Mrunmoy/pico-3d-mouse/mechanical/README.txt

Current mechanical documentation: README.md
Current master: output/two-piece/SpaceMouse_TwoPiece.f3d
Earlier output folders are historical revisions, not current print parts.
