Mrunmoy/pico-3d-mouse/mechanical/om300b.pdf

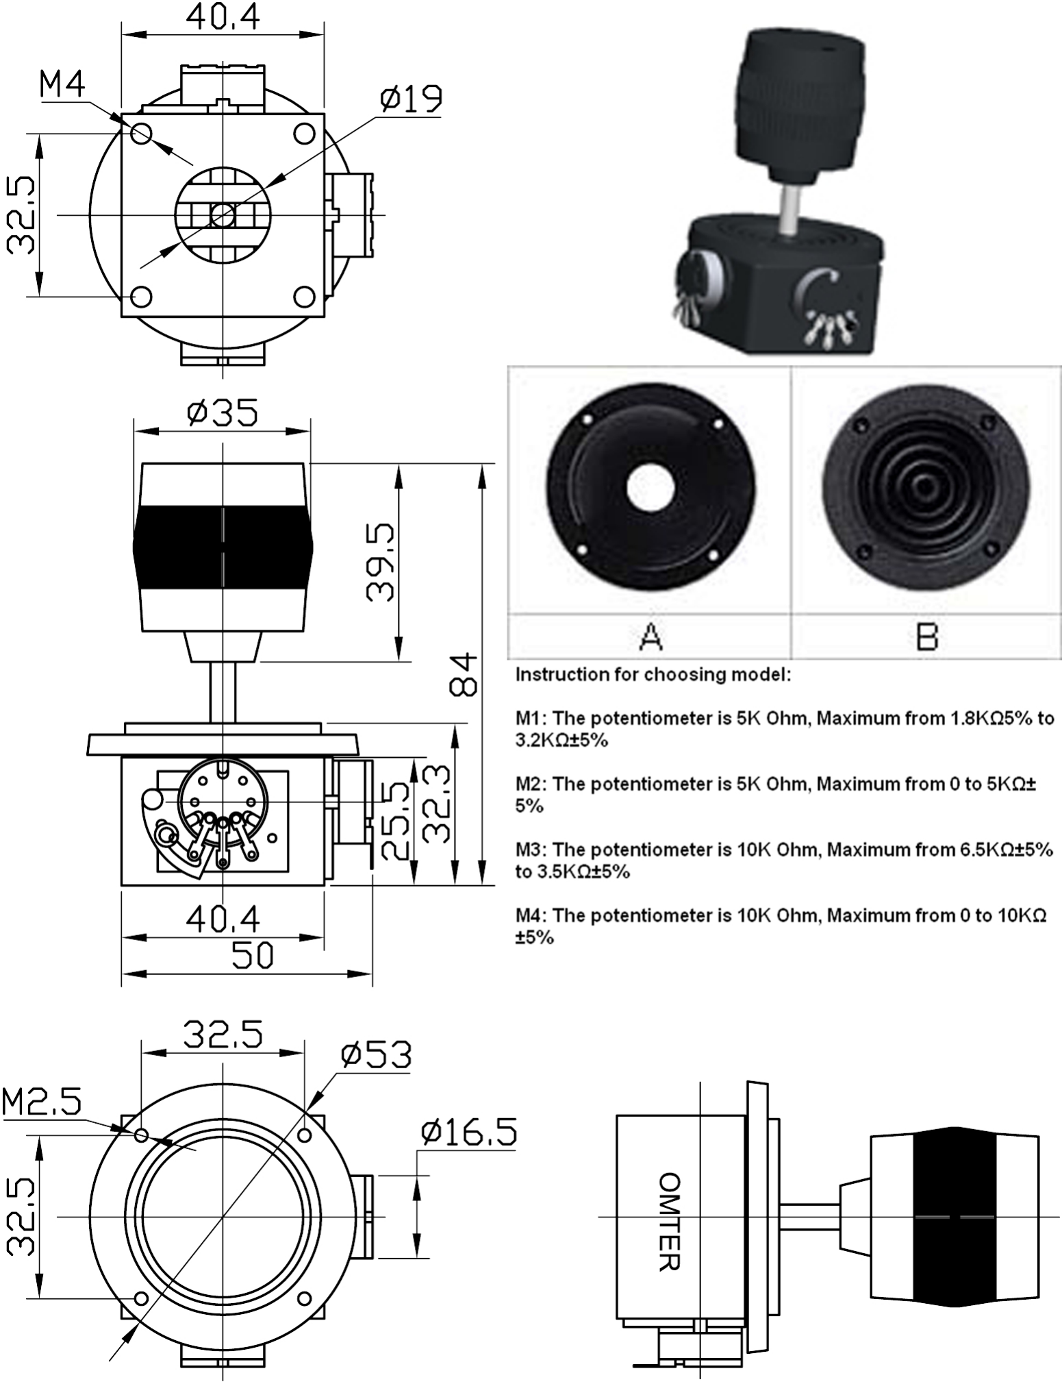
[picture p14: page 1]
