Mrunmoy/pico-3d-mouse/mechanical/docs/images/joint-section.png

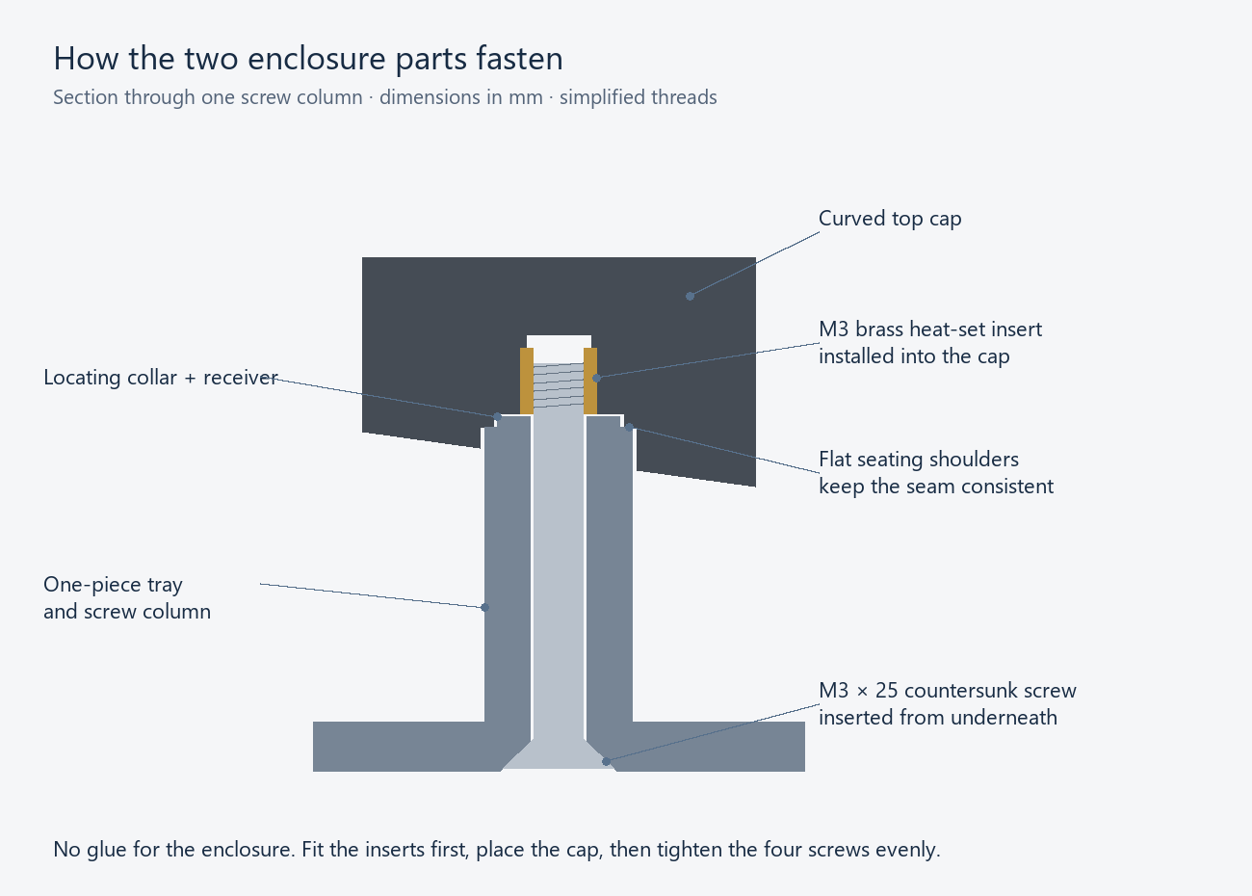
mechanical/docs/images/joint-section.png
