Mrunmoy/pico-3d-mouse/mechanical/output/two-piece/Bambu_top_and_retainer_ready.png

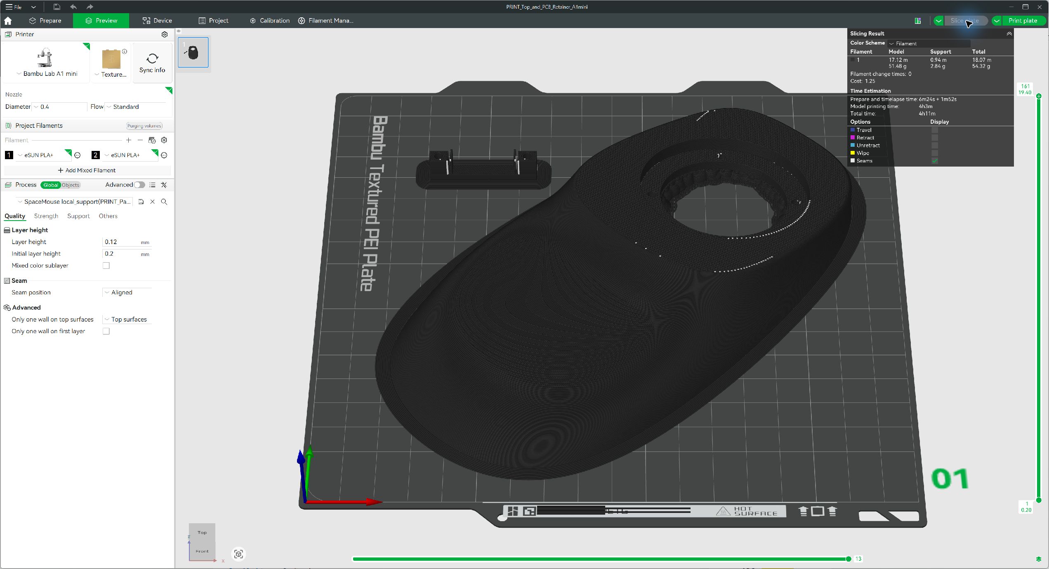
mechanical/output/two-piece/Bambu_top_and_retainer_ready.png
