Mrunmoy/pico-3d-mouse/mechanical/output/two-piece/Left_hand_top.png

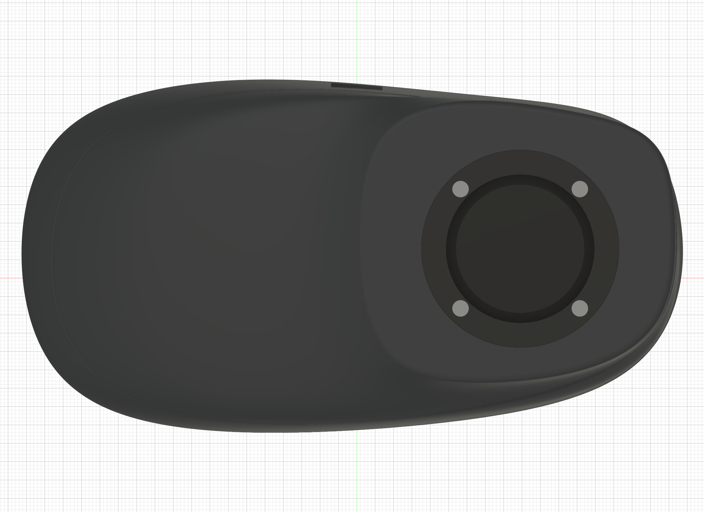
mechanical/output/two-piece/Left_hand_top.png
