Mrunmoy/pico-3d-mouse/mechanical/output/two-piece/TPU_Strip_2_print.stl

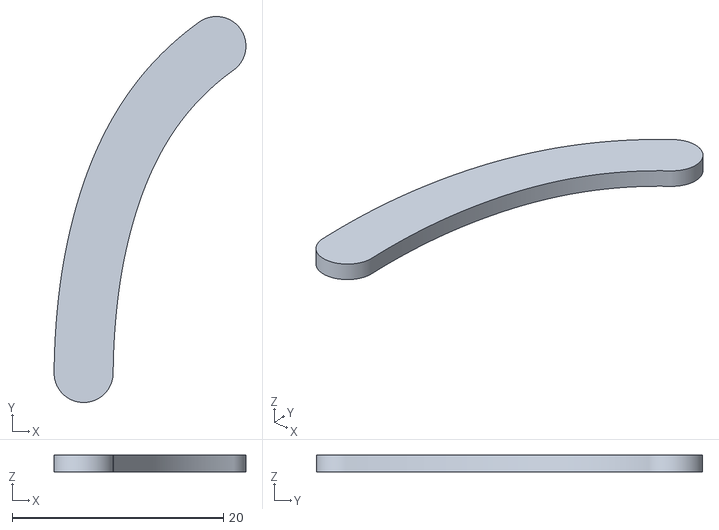
[picture p18: CAD file, 2026-10-29]
mechanical/output/two-piece/TPU_Strip_2_print.stl
18.2 x 36.6 x 1.60
