Mrunmoy/pico-3d-mouse/mechanical/output/two-piece/TPU_Strip_1_print.stl

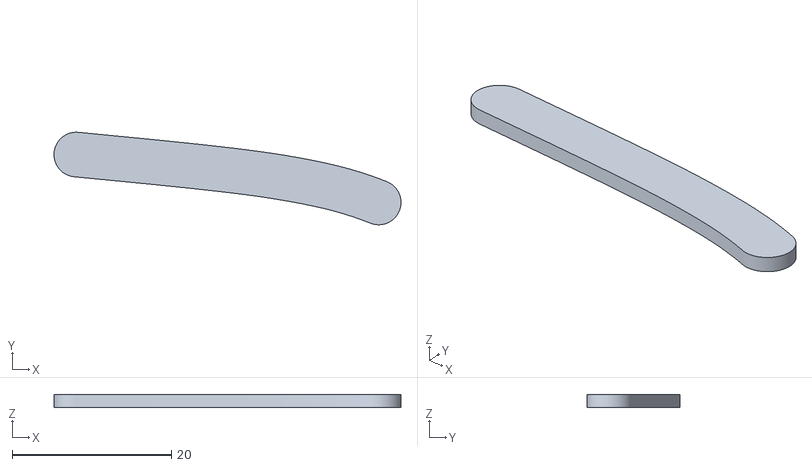
[picture p19: CAD file, 2026-10-29]
mechanical/output/two-piece/TPU_Strip_1_print.stl
43.5 x 11.6 x 1.60
