Mrunmoy/pico-3d-mouse/mechanical/output/two-piece/TPU_Strip_3_print.stl

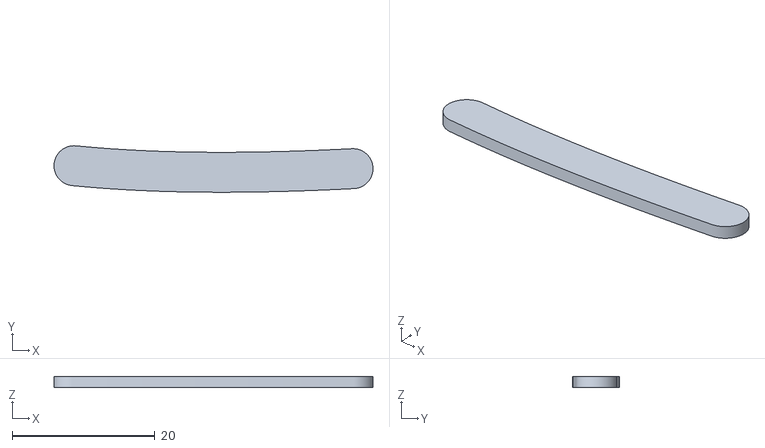
[picture p20: CAD file, 2026-10-29]
mechanical/output/two-piece/TPU_Strip_3_print.stl
44.7 x 6.52 x 1.60
