Mrunmoy/pico-3d-mouse/mechanical/output/two-piece/TPU_Strip_4_print.stl

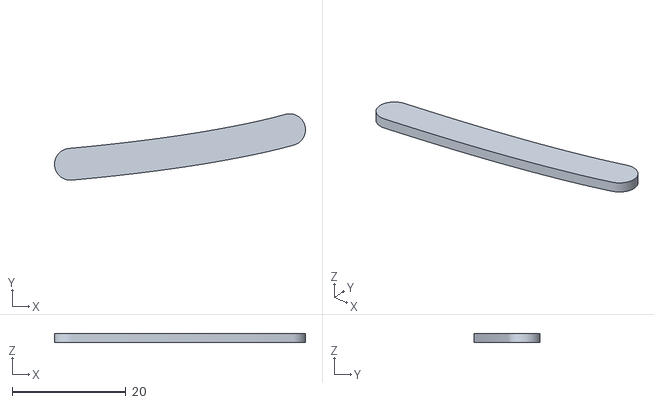
[picture p21: CAD file, 2026-10-29]
mechanical/output/two-piece/TPU_Strip_4_print.stl
44.1 x 11.7 x 1.60
