Mrunmoy/pico-3d-mouse/mechanical/output/two-piece/Base_Tray_print.stl

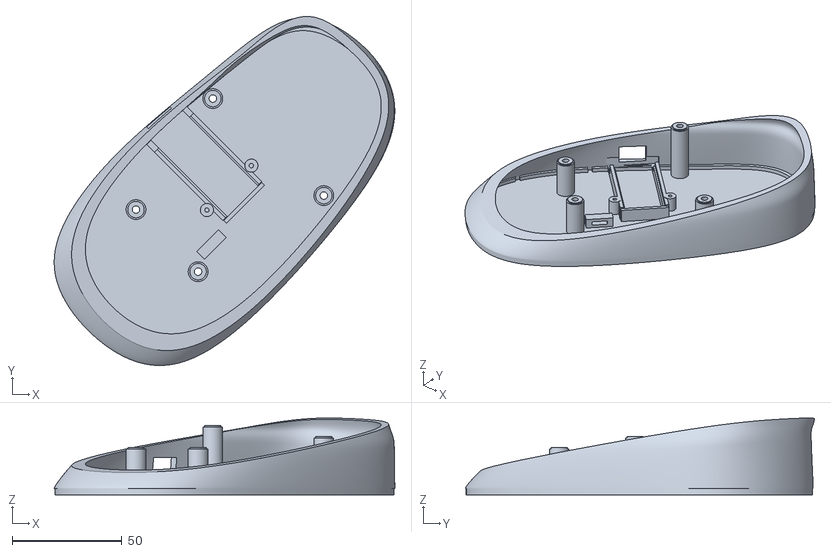
[picture p22: CAD file, 2026-10-29]
mechanical/output/two-piece/Base_Tray_print.stl
155.1 x 159.0 x 35.1
