Mrunmoy/pico-3d-mouse/mechanical/output/two-piece/PRINT_Top_and_PCB_Retainer_A1mini.3mf

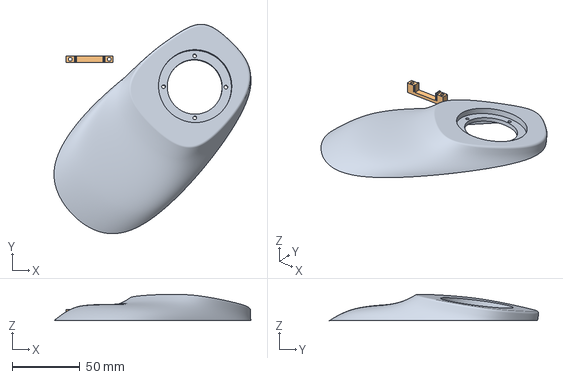
[picture p23: CAD file, 2026-10-29]
mechanical/output/two-piece/PRINT_Top_and_PCB_Retainer_A1mini.3mf
144.9 x 154.0 x 19.4 mm
Palm_Cap
PCB_Retainer_print.stl
