Mrunmoy/pico-3d-mouse/mechanical/output/two-piece/PCB_Retainer_print.stl

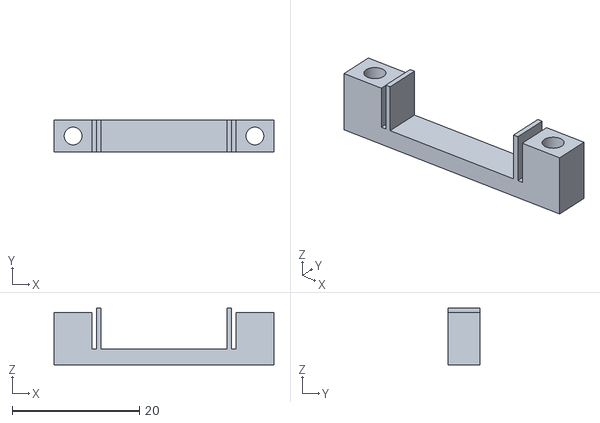
[picture p24: CAD file, 2026-10-29]
mechanical/output/two-piece/PCB_Retainer_print.stl
34.6 x 5.00 x 8.90
