Mrunmoy/pico-3d-mouse/mechanical/output/two-piece/Palm_Cap_print.stl

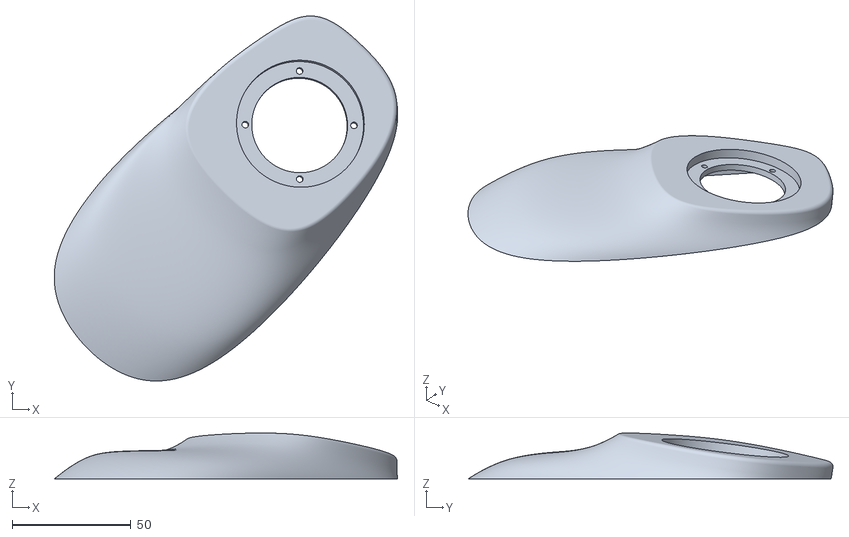
[picture p25: CAD file, 2026-10-29]
mechanical/output/two-piece/Palm_Cap_print.stl
144.9 x 154.0 x 19.4
