Mrunmoy/pico-3d-mouse/(list of files, cad)

Other CAD files:
mechanical/output/two-piece/PRINT_Base_Tray_A1mini.3mf
mechanical/output/two-piece/SpaceMouse_TwoPiece.f3d
