Mrunmoy/pico-3d-mouse/(commit log)

2026-10-24 Revise Concept C hand layout and add measured flush joystick mount
    [Bottom_Cover_print.stl, ConceptC_Complete.f3d, ConceptC_Complete_Assembly.step, ConceptC_Exploded.f3d, ConceptC_Palm25.f3d, PCB_Retainer_print.stl, Upper_Shell_print.3mf, Upper_Shell_print.stl]
2026-10-24 Record single R2 master in SpaceMouse and close extra Fusion tabs
    [ConceptC_Complete.f3d]
2026-10-24 Remove four obsolete cloud mouse prototypes and preserve R2 master
2026-10-24 Lower front palm support with gentle slope and shallow ergonomic cradle
    [SpaceMouse_Master.f3d, Upper_Shell_print.stl]
2026-10-24 Export SpaceMouse CAD reference views and ergonomic concept brief
2026-10-24 Lower finger shoulder and blend SpaceMouse shell into continuous ramp
    [SpaceMouse_Master.f3d, Upper_Shell_print.stl]
2026-10-25 Round SpaceMouse crown and shorten hand-entry edge by 12 mm
    [Bottom_Cover_print.stl, PCB_Retainer_print.stl, SpaceMouse_Master.f3d, Upper_Shell_print.stl]
2026-10-25 Restore asymmetric palm support and smooth SpaceMouse sidewalls
    [Bottom_Cover_print.stl, PCB_Retainer_print.stl, SpaceMouse_Master.f3d, Upper_Shell_print.stl]
2026-10-25 Replace round feet with curved perimeter TPU inserts
    [Bottom_Cover_print.stl, SpaceMouse_Master.f3d, TPU_Strip_1_print.stl, TPU_Strip_2_print.stl, TPU_Strip_3_print.stl, TPU_Strip_4_print.stl]
2026-10-25 Save A1 Mini top cover slicing setup with supports and brim
    [Top_Cover_A1mini_0p12.3mf]
2026-10-25 Save separate split-shell review concept and CAD previews
    [Bottom_Cover_NoSupports_Audit.3mf, Bottom_Cover_print.stl, Lower_Frame_NoSupports_Audit.3mf, Lower_Frame_print.stl, Palm_Cap_NoSupports_Audit.3mf, Palm_Cap_print.stl, SpaceMouse_Split_Concept.f3d]
2026-10-25 Build two-piece tray and registered cap with countersunk M3 fastening
    [Base_Tray_NoSupports_Audit.3mf, Base_Tray_print.stl, Palm_Cap_NoSupports_Audit.3mf, Palm_Cap_print.stl, SpaceMouse_TwoPiece.f3d]
2026-10-25 Distribute case fixings and validate final two-piece slicing
    [Base_Tray_NoSupports_Audit.3mf, Base_Tray_print.stl, PRINT_Base_Tray_A1mini.3mf, PRINT_Palm_Cap_A1mini.3mf, Palm_Cap_NoSupports_Audit.3mf, Palm_Cap_print.stl, SpaceMouse_TwoPiece.f3d]
2026-10-25 Keep latest SpaceMouse as the single Fusion master
    [SpaceMouse_TwoPiece.f3d]
2026-10-25 Correct left-hand assembly and regenerate validated print projects
    [Base_Tray_NoSupports_Audit.3mf, Base_Tray_print.stl, PRINT_Base_Tray_A1mini.3mf, PRINT_Palm_Cap_A1mini.3mf, Palm_Cap_NoSupports_Audit.3mf, Palm_Cap_print.stl, SpaceMouse_TwoPiece.f3d]
2026-10-27 Check long insert clearance and preserve safe cap geometry
    [SpaceMouse_TwoPiece.f3d]
2026-10-27 Adapt palm cap to Amazon M3 L4 D4.2 inserts and refresh print exports
    [PRINT_Palm_Cap_A1mini.3mf, Palm_Cap_NoSupports_Audit.3mf, Palm_Cap_print.stl, SpaceMouse_TwoPiece.f3d]
2026-10-27 Package cap and PCB retainer on one Bambu plate and assess tilt adhesion
    [PCB_Retainer_print.stl, PRINT_Top_and_PCB_Retainer_A1mini.3mf]
2026-10-29 Initial commit: RP2040 3-channel ADC potentiometer driver and bringup firmware
2026-10-29 Refactor to SOLID modular architecture with colocated TDD tests, scripts, and wiring diagram
2026-10-29 feat(firmware): add composite 6-DOF USB HID, QSPI flash calibration store, and buttonless BOOTSEL command
2026-10-29 feat(ui): add event-driven Qt6 MVC manufacturing tester, calibration, and buttonless firmware updater
2026-10-29 feat(ui): add guided 6-step ManufacturingWizardWidget for intuitive step-by-step calibration and testing
2026-10-29 fix(ui): align wizard calibration events with firmware CENTER_CALIBRATED/MINMAX_CAPTURED and add button press feedback
    [ManufacturingController.cpp, ManufacturingWizardWidget.cpp, test_manufacturing_controller.cpp]
2026-10-29 fix(usb): remove RP2040 Reset vendor interface and use 3Dconnexion 256f:c631 IN/OUT HID for Windows 3DxWare
    [Rp2040HidTransport.cpp, Rp2040UsbDescriptors.cpp, test_rp2040_platform.cpp]
2026-10-29 chore(flash): filter ttyACM 1200-baud BOOTSEL trigger by pico-3d-mouse USB VID
2026-10-29 Make mechanical paths portable and publish CAD gallery and assembly docs
2026-10-29 Remove obsolete mechanical variations and keep current design only
    [Bottom_Cover_NoSupports_Audit.3mf, Bottom_Cover_print.stl, ConceptC_Complete.f3d, ConceptC_Complete_Assembly.step, ConceptC_Exploded.f3d, ConceptC_Palm25.f3d, Lower_Frame_NoSupports_Audit.3mf, Lower_Frame_print.stl]
2026-10-29 Keep two print projects and preserve four TPU strip accessories
    [Base_Tray_NoSupports_Audit.3mf, PRINT_Palm_Cap_A1mini.3mf, Palm_Cap_NoSupports_Audit.3mf, TPU_Strip_1_print.stl, TPU_Strip_2_print.stl, TPU_Strip_3_print.stl, TPU_Strip_4_print.stl]
2026-10-29 fix(usb,domain): place 3Dconnexion HID on Interface 0/EP1 and drive all 6-DOF axes
    [AppController.cpp, Rp2040UsbDescriptors.cpp, test_app_controller.cpp]
2026-10-29 docs(readme): organize README with table of contents and logical reader flow
